wackyfrog/ZD50-controller/README.md

# ZD50-controller
Controller for audio power amplifier. Features: power control with soft start, SPI multi channel volume control, infrared remote control, multicolor backlight.

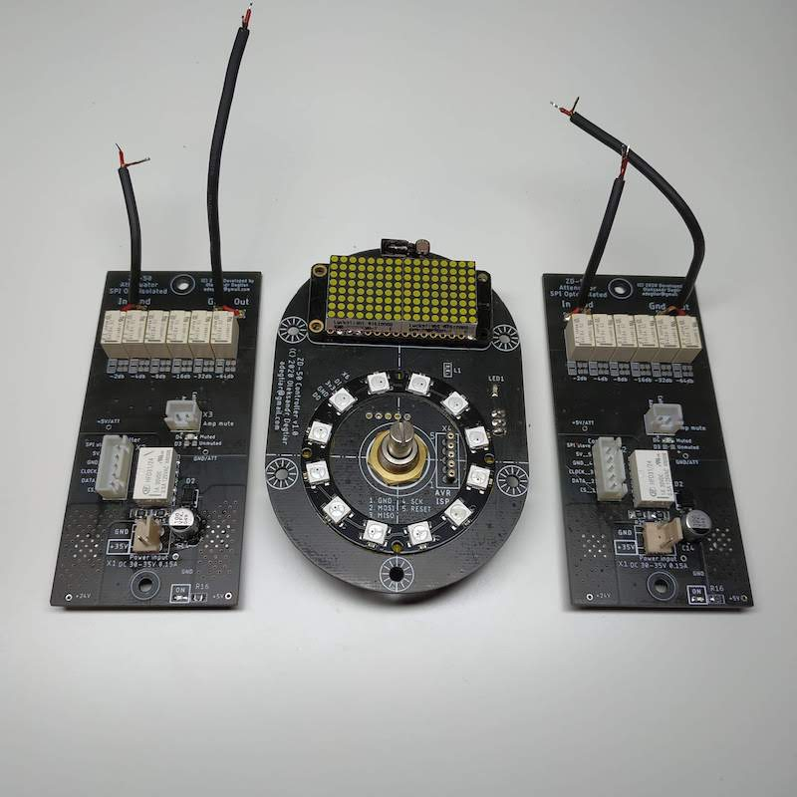
[picture p1: images/IMG_20210211_191846.jpg]
Assembled modules

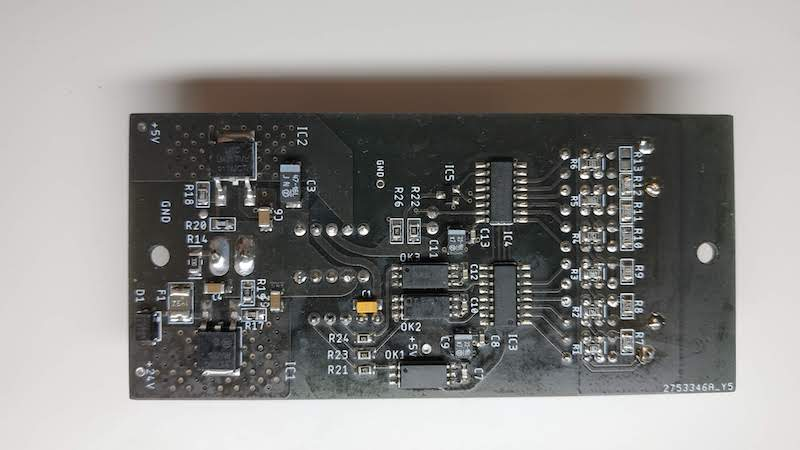
[picture p2: images/IMG_20210211_192029.jpg]
Assembled attenuator, bottom

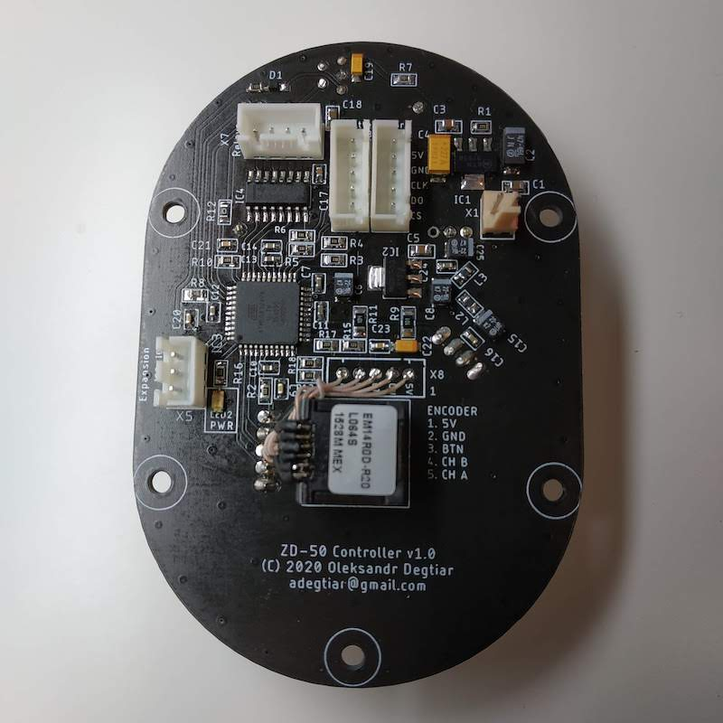
[picture p3: images/IMG_20210211_192253.jpg]
Assembled controller, bottom

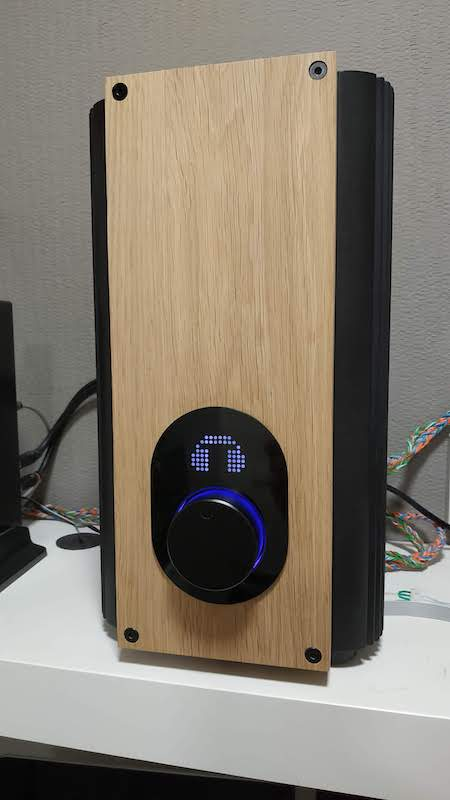
[picture p4: images/IMG_20210302_191737.jpg]
In use
