wackyfrog/ZD50-controller/schematics/Attenuator-schematics.pdf

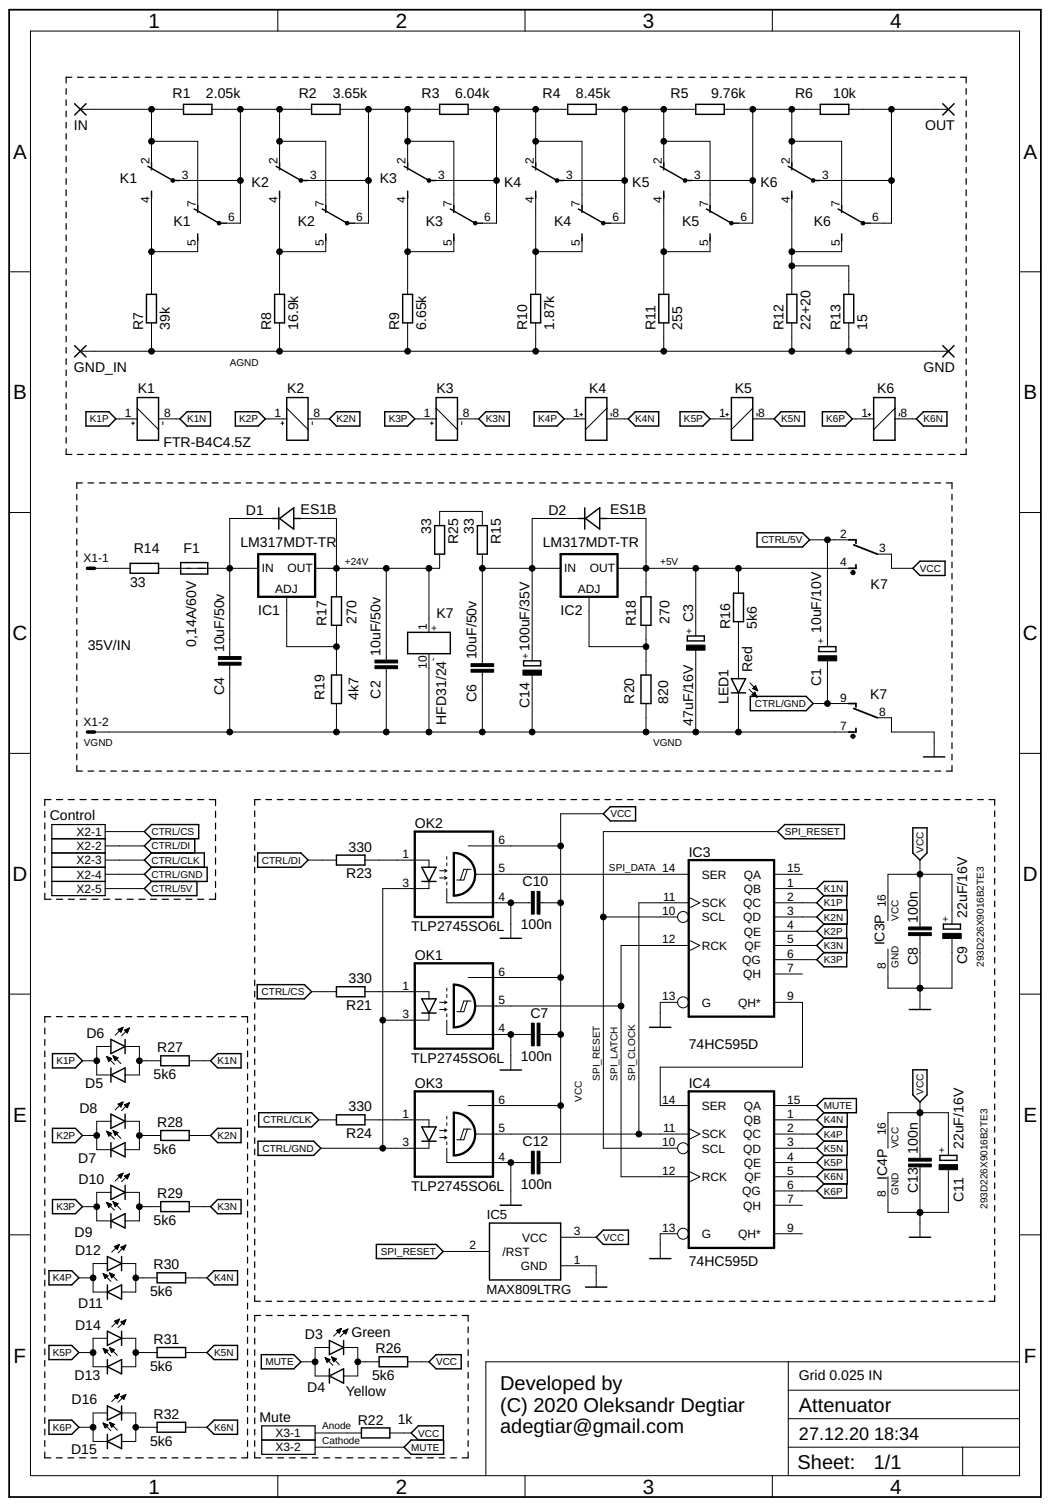
[picture p5: page 1]

X2-4 | CTRL/GND

Grid 0.025 IN Developed by
