wackyfrog/ZD50-controller/schematics/ZD-50 Controller v1.pdf

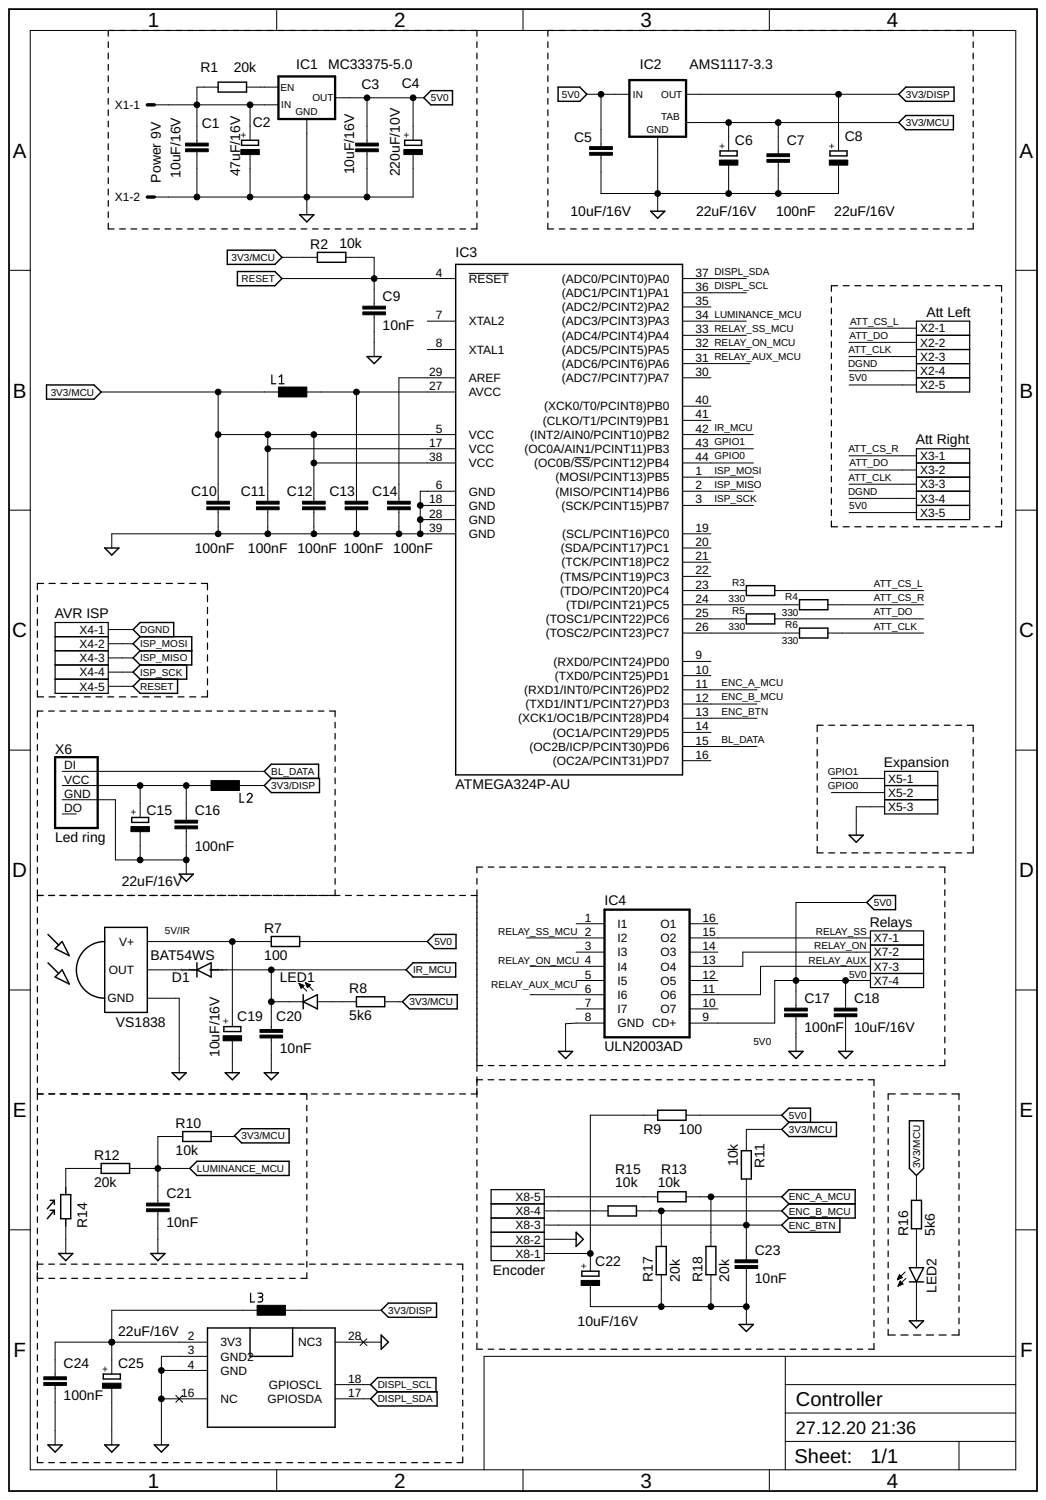
[picture p6: page 1]

5 | Att Right
17 | 43 GPIO1
