wackyfrog/ZD50-controller/schematics/Attenuator.sch

## EAGLE design schematics/Attenuator.sch (2023-03-28)

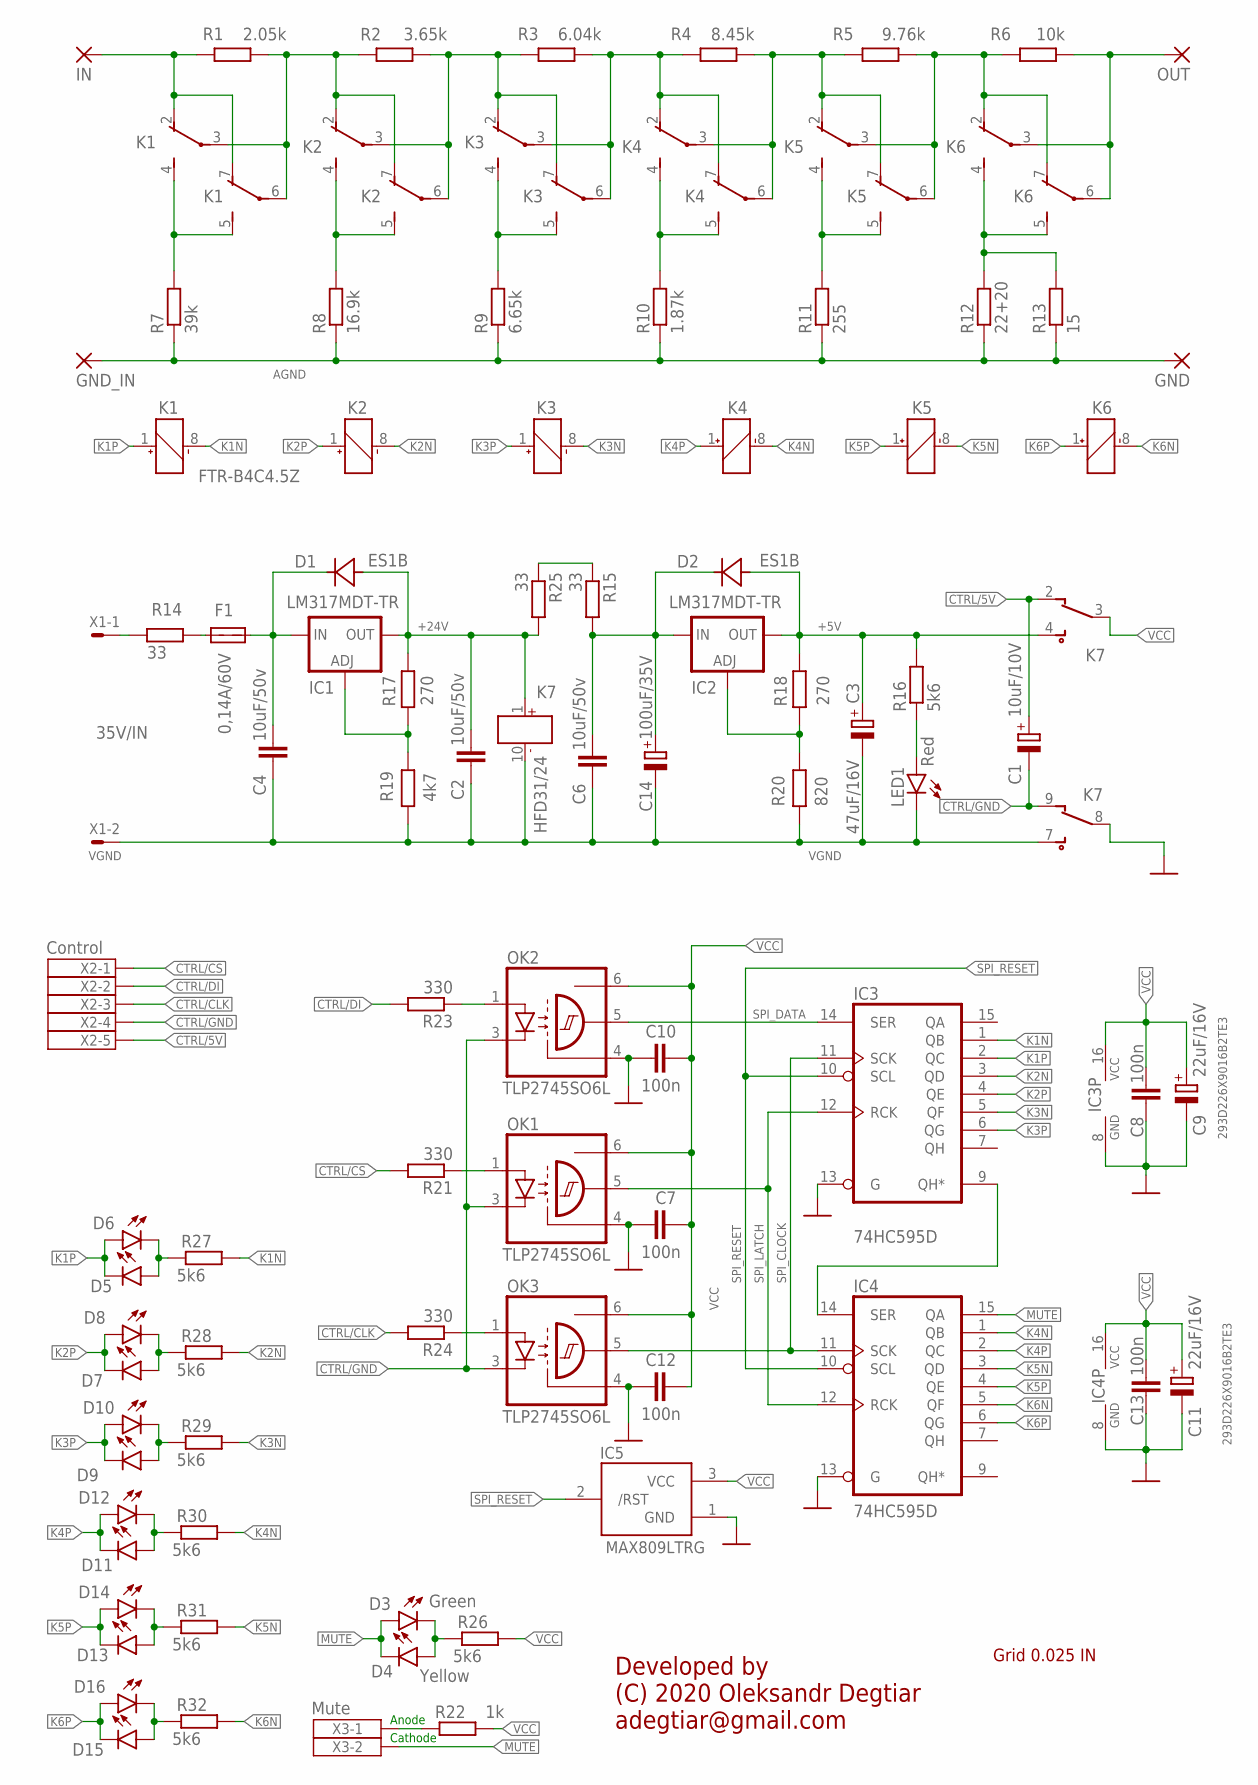
[picture p7: schematic Attenuator.sch]

Parts:
C1: 10uF/10V; SMC_A; PARTNAME TAJA106K010RNJ
C2, C4, C6: 10uF/50v; C1206; PARTNAME CL31B106KBHNNNE
C3: 47uF/16V; SMC_C; PARTNAME 293D476X9016C2TE3
C7, C8, C10, C12, C13: 100n; C0603
C9, C11: 22uF/16V; SMC_B; PARTNAME 293D226X9016B2TE3
C14: 100uF/35V; UD-6,3X5,8_NICHICON; PARTNAME EEEFK1V101XP
D1, D2: ES1B; SMA
D3: Green; CHIPLED_0805
D4: Yellow; CHIPLED_0805
D5, D6, D7, D8, D9, D10, D11, D12, D13, D14, D15, D16: LEDCHIPLED_0805; CHIPLED_0805
F1: 0,14A/60V; MF-MSMF010-2
GND: OUT_GND; 2,54/1,1
GND_IN: IN_GND; 2,54/1,1
IC1: LM317MDT-TR; DPACK
IC2: LM317MDT-TR; DPACK; PARTNAME LM317MDTG
IC3, IC4: 74HC595D; SO16
IC5: MAX809LTRG; SOT23; PARTNAME MAX809LTRG
IN: IN; 2,54/1,1
K1, K2, K3, K4, K5, K6: FTR-B4C4.5Z; FTR-B4C
K7: HFD31/24; HFD31
LED1: Red; CHIPLED_0805
OK1, OK2, OK3: TLP2745SO6L; SO6L
OUT: OUT; 2,54/1,1
R1: 2.05k; R0805
R2: 3.65k; R0805
R3: 6.04k; R0805
R4: 8.45k; R0805
R5: 9.76k; R0805
R6: 10k; R0805
R7: 39k; R0805
R8: 16.9k; R0805
R9: 6.65k; R0805
R10: 1.87k; R0805
R11: 255; R0805
R12: 22+20; R0805
R13: 15; R0805
R14, R15, R25: 33; R1206
R16, R26, R27, R28, R29, R30, R31, R32: 5k6; R0805
R17, R18: 270; R0805
R19: 4k7; R0805
R20: 820; R0805
R21, R23, R24: 330; R0805
R22: 1k; R0805
X1: 35V/IN; KK-156-2
X2: Control; JST-XH-05-PACKAGE-ROUND-PAD
X3: Mute; JST-XH-02-PACKAGE-ROUND-PAD

Connections:
+5V: C3.+, D2.A, IC2.4 (OUT), K7.4 (NO), R16.2, R18.1
+24V: C2.1, D1.A, IC1.4 (OUT), K7.1 (+), R17.1, R25.2
+24V/IN: C6.1, C14.+, D2.C, IC2.3 (IN), R15.2
+35V/FUSE: F1.1, R14.2
+35V/IN: R14.1, X1.1
ADJ_VR1: IC1.1 (ADJ), R17.2, R19.2
ADJ_VR2: IC2.1 (ADJ), R18.2, R20.2
AGND: GND.1, GND_IN.1, R7.1, R8.1, R9.1, R10.1, R11.1, R12.1, R13.1
CTRL/5V: C1.+, K7.2 (NC), X2.5
CTRL/CLK: R24.2, X2.3
CTRL/CS: R21.2, X2.1
CTRL/DI: R23.2, X2.2
CTRL/GND: C1.-, K7.9 (NC), OK1.3 (C), OK2.3 (C), OK3.3 (C), X2.4
GND: C7.2, C8.2, C9.-, C10.2, C11.-, C12.2, C13.1, IC3.8 (GND), IC3.13 (G), IC4.8 (GND), IC4.13 (G), IC5.1 (GND), K7.8 (COM), OK1.4 (GND), OK2.4 (GND), OK3.4 (GND)
K1N: IC3.1 (QB), K1.8 (-), R27.2
K1P: D5.C, D6.A, IC3.2 (QC), K1.1 (+)
K2N: IC3.3 (QD), K2.8 (-), R28.2
K2P: D7.C, D8.A, IC3.4 (QE), K2.1 (+)
K3N: IC3.5 (QF), K3.8 (-), R29.2
K3P: D9.C, D10.A, IC3.6 (QG), K3.1 (+)
K4N: IC4.1 (QB), K4.8 (-), R30.2
K4P: D11.C, D12.A, IC4.2 (QC), K4.1 (+)
K5N: IC4.3 (QD), K5.8 (-), R31.2
K5P: D13.C, D14.A, IC4.4 (QE), K5.1 (+)
K6N: IC4.5 (QF), K6.8 (-), R32.2
K6P: D15.C, D16.A, IC4.6 (QG), K6.1 (+)
LED_PWR_ON: LED1.A, R16.1
MUTE: D3.A, D4.C, IC4.15 (QA), X3.2
unnamed: K5.4 (S), K5.5 (S), R11.2
unnamed: K3.4 (S), K3.5 (S), R9.2
unnamed: K2.4 (S), K2.5 (S), R8.2
unnamed: K1.4 (S), K1.5 (S), R7.2
unnamed: D5.A, D6.C, R27.1
unnamed: K4.4 (S), K4.5 (S), R10.2
unnamed: K4.3, K4.6, K5.2 (O), K5.7 (O), R4.1, R5.2
unnamed: K1.3, K1.6, K2.2 (O), K2.7 (O), R1.1, R2.1
unnamed: IN.1, K1.2 (O), K1.7 (O), R1.2
unnamed: K2.3, K2.6, K3.2 (O), K3.7 (O), R2.2, R3.2
unnamed: K3.3, K3.6, K4.2 (O), K4.7 (O), R3.1, R4.2
unnamed: K6.3, K6.6, OUT.1, R6.1
unnamed: R15.1, R25.1
unnamed: D3.C, D4.A, R26.1
unnamed: D7.A, D8.C, R28.1
unnamed: R22.1, X3.1
unnamed: D9.A, D10.C, R29.1
unnamed: C4.1, D1.C, F1.2, IC1.3 (IN)
unnamed: K5.3, K5.6, K6.2 (O), K6.7 (O), R5.1, R6.2
unnamed: D11.A, D12.C, R30.1
unnamed: D13.A, D14.C, R31.1
unnamed: D15.A, D16.C, R32.1
unnamed: K6.4 (S), K6.5 (S), R12.2, R13.2
unnamed: OK1.1 (A), R21.1
unnamed: OK2.1 (A), R23.1
unnamed: OK3.1 (A), R24.1
RG_CHAIN: IC3.9 (QH*), IC4.14 (SER)
SPI_CLOCK: IC3.11 (SCK), IC4.11 (SCK), OK3.5 (OUT)
SPI_DATA: IC3.14 (SER), OK2.5 (OUT)
SPI_LATCH: IC3.12 (RCK), IC4.12 (RCK), OK1.5 (OUT)
SPI_RESET: IC3.10 (SCL), IC4.10 (SCL), IC5.2 (/RST)
VCC: C7.1, C8.1, C9.+, C10.1, C11.+, C12.1, C13.2, IC3.16 (VCC), IC4.16 (VCC), IC5.3 (VCC), K7.3 (COM), OK1.6 (VCC), OK2.6 (VCC), OK3.6 (VCC), R22.2, R26.2
VGND: C2.2, C3.-, C4.2, C6.2, C14.-, K7.7 (NO), K7.10 (-), LED1.C, R19.1, R20.1, X1.2

Notes on the sheet:
Cathode
Anode
Grid 0.025 IN
Developed by (C) 2020 Oleksandr Degtiar adegtiar@gmail.com
