wackyfrog/ZD50-controller/schematics/Controller v1.1.sch

## EAGLE design schematics/Controller v1.1.sch (2023-03-28)

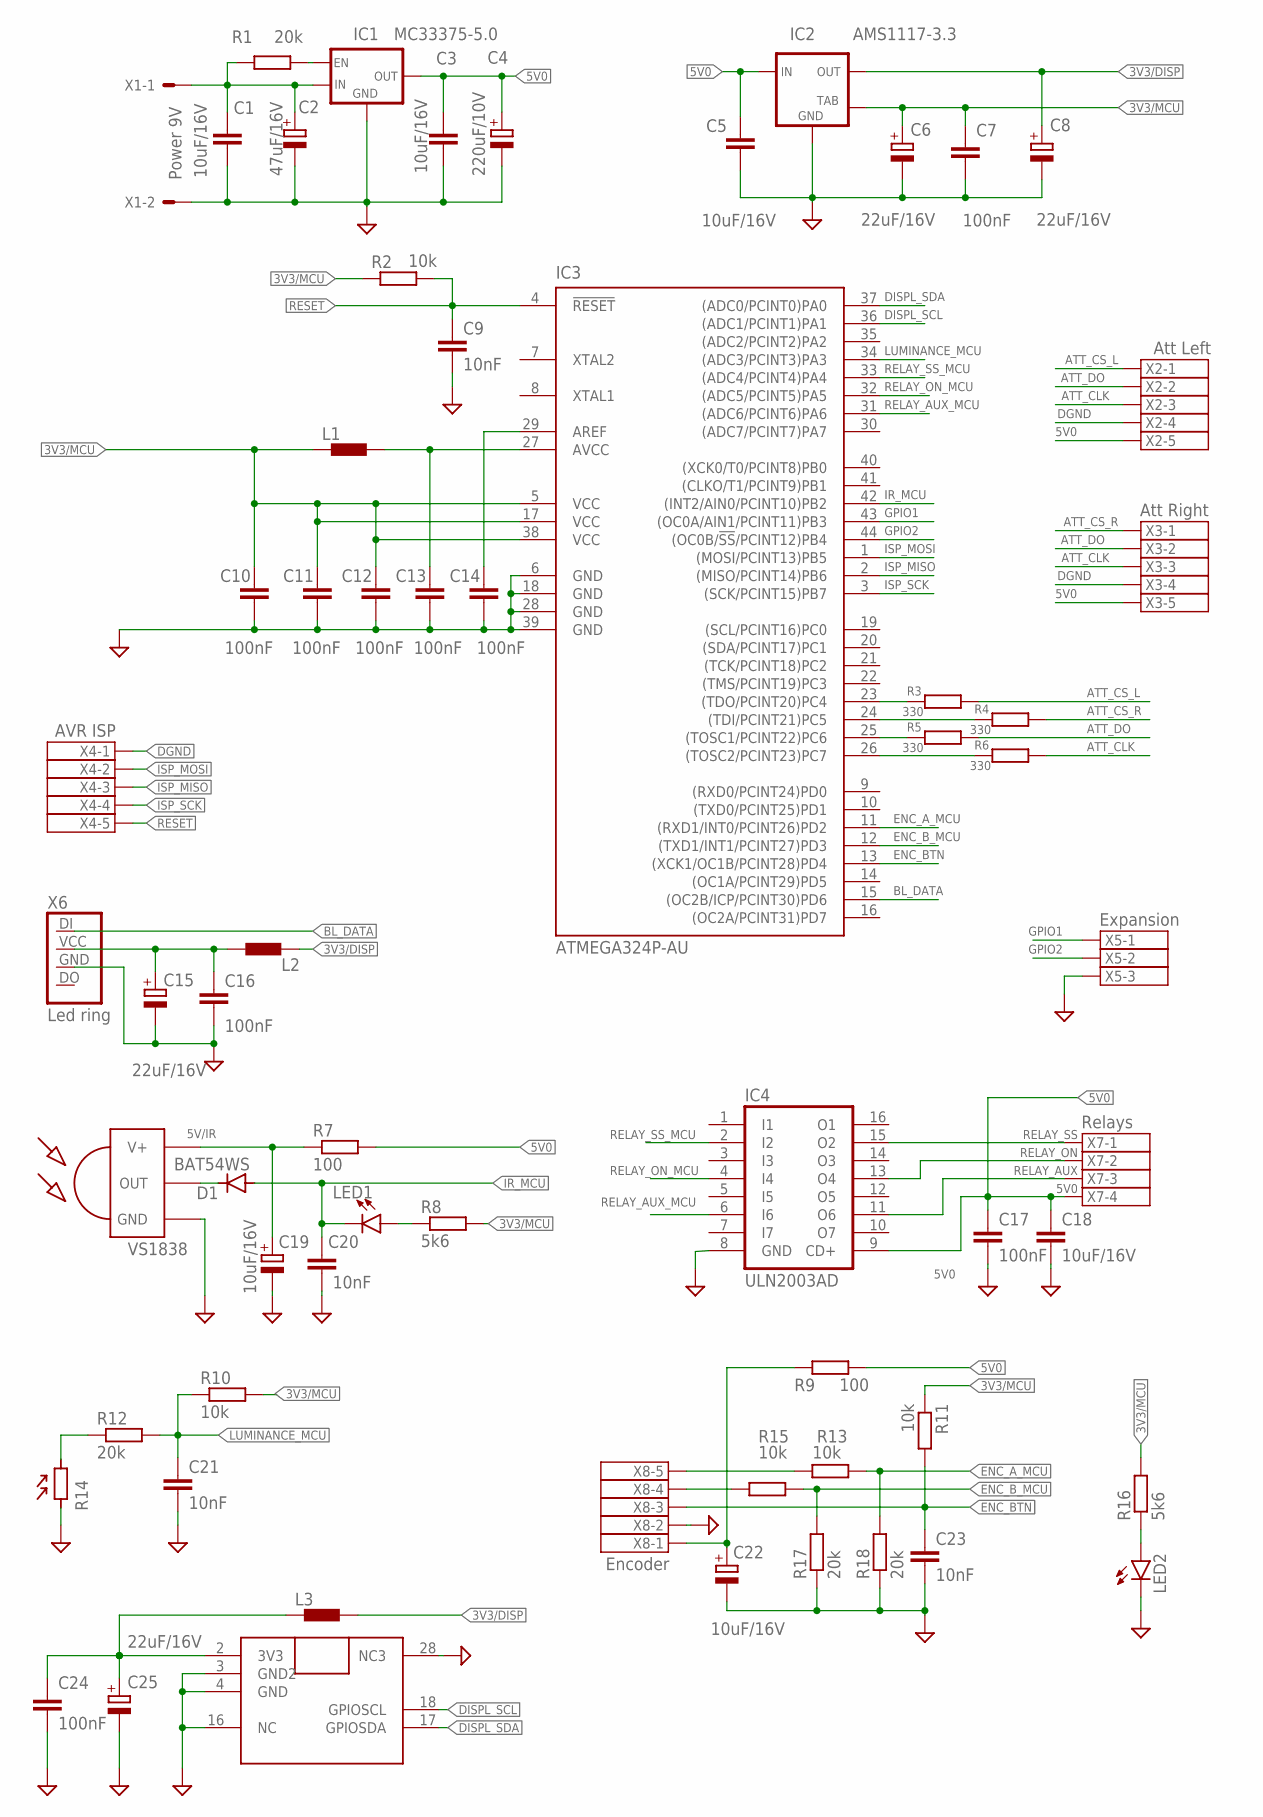
[picture p8: schematic Controller v1.1.sch]

Parts:
C1, C3, C5, C18: 10uF/16V; C0805; PARTNAME CL21B106KOQNNNE
C2: 47uF/16V; SMC_C; PARTNAME 293D476X9016C2TE3
C4: 220uF/10V; SMC_C
C6, C8, C15, C25: 22uF/16V; SMC_B; PARTNAME 293D226X9016B2TE3
C7, C10, C11, C12, C13, C14, C16, C17, C24: 100nF; C0603
C9, C20, C21: 10nF; C0603
C19, C22: 10uF/16V; SMC_A; PARTNAME TAJA106K010RNJ
C23: 10nF; C0603; PARTNAME CL21B106KOQNNNE
D1: BAT54WS; SOD323-W; PARTNAME BAT54WS
DM1: FEATHERWING_ZD50DISPLAY_ZD50; FEATHERWING_ZD50
IC1: MC33375-5.0; SOT223
IC2: AMS1117-3.3; SOT223
IC3: ATMEGA324P-AU; TQFP44
IC4: ULN2003AD; SO16
IR1: VS1838; TSOP18XX
L1, L2: BLM21PG221SN1D; 0805; PARTNAME BLM21PG221SN1D
L3: 10uH; 0805; PARTNAME BLM21PG221SN1D
LED1, LED2: LEDSML0805; SML0805
R1: 20k; R0603
R2, R10, R13, R15: 10k; R0805
R3, R4, R5, R6: 330; R0805
R7: 100; R0805
R8, R16: 5k6; R0805
R9: 100; R1206
R11: 10k; R1206
R12, R17, R18: 20k; R0805
R14: GL5537; GL55
X1: Power 9V; 22-23-2021
X2: Att Left; JST-XH-05-PACKAGE-LONG-PAD
X3: Att Right; JST-XH-05-PACKAGE-LONG-PAD
X4: AVR ISP; JST-XH-05-PACKAGE-LONG-PAD
X5: Expansion; JST-XH-03-PACKAGE-LONG-PAD
X6: Led ring; LED_RING_CONN
X7: Relays; JST-XH-04-PACKAGE-LONG-PAD
X8: Encoder; JST-XH-05-PACKAGE-ROUND-PAD

Connections:
3V3/AVCC: C13.1, IC3.27 (AVCC), L1.2
3V3/DISP: C8.+, IC2.2 (OUT), L2.2, L3.2
3V3/MCU: C6.+, C7.1, C10.1, C11.1, C12.1, IC2.4 (TAB), IC3.5 (VCC), IC3.17 (VCC), IC3.38 (VCC), L1.1, R2.1, R8.2, R10.2, R11.1, R16.2
5V0: C3.1, C4.+, C5.1, C17.1, C18.1, IC1.3 (OUT), IC2.3 (IN), IC4.9 (CD+), R7.2, R9.2, X2.5, X3.5, X7.4
5V/EN: IC1.2 (EN), R1.2
5V/ENC: C22.+, R9.1, X8.1
5V/IR: C19.+, IR1.VCC (V+), R7.1
+9V/IN: C1.1, C2.+, IC1.1 (IN), R1.1, X1.1
AREF: C14.1, IC3.29 (AREF)
ATT_CLK: R6.2, X2.3, X3.3
ATT_CS_L: R3.2, X2.1
ATT_CS_R: R4.2, X3.1
ATT_DO: R5.2, X2.2, X3.2
BL_3V3: C15.+, C16.1, L2.1, X6.VCC
BL_DATA: IC3.15 ((OC2B/ICP/PCINT30)PD6), X6.DI
DGND: C1.2, C2.-, C3.2, C4.-, C5.2, C6.-, C7.2, C8.-, C9.2, C10.2, C11.2, C12.2, C13.2, C14.2, C15.-, C16.2, C17.2, C18.2, C19.-, C20.2, C21.2, C22.-, C23.2, C24.2, C25.-, DM1.3 (GND2), DM1.4 (GND), DM1.16 (NC), DM1.28 (NC3), IC1.4 (GND), IC2.1 (GND), IC3.6 (GND), IC3.18 (GND), IC3.28 (GND), IC3.39 (GND), IC4.8 (GND), IR1.GND, LED2.C, R14.P$1, R17.1, R18.1, X1.2, X2.4, X3.4, X4.1, X5.3, X6.GND, X8.2
DISPL_3V3: C24.1, C25.+, DM1.2 (3V3), L3.1
DISPL_SCL: DM1.18 (GPIOSCL), IC3.36 ((ADC1/PCINT1)PA1)
DISPL_SDA: DM1.17 (GPIOSDA), IC3.37 ((ADC0/PCINT0)PA0)
ENC_A: R13.1, X8.5
ENC_A_MCU: IC3.11 ((RXD1/INT0/PCINT26)PD2), R13.2, R18.2
ENC_B: R15.1, X8.4
ENC_BTN: C23.1, IC3.13 ((XCK1/OC1B/PCINT28)PD4), R11.2, X8.3
ENC_B_MCU: IC3.12 ((TXD1/INT1/PCINT27)PD3), R15.2, R17.2
GPIO1: IC3.43 ((OC0A/AIN1/PCINT11)PB3), X5.1
GPIO2: IC3.44 ((OC0B/!SS!/PCINT12)PB4), X5.2
IR_MCU: C20.1, D1.A, IC3.42 ((INT2/AIN0/PCINT10)PB2), LED1.C
IR_OUT: D1.C, IR1.OUT
ISP_MISO: IC3.2 ((MISO/PCINT14)PB6), X4.3
ISP_MOSI: IC3.1 ((MOSI/PCINT13)PB5), X4.2
ISP_SCK: IC3.3 ((SCK/PCINT15)PB7), X4.4
LIGHT_SENSOR: R12.1, R14.P$2
LUMINANCE_MCU: C21.1, IC3.34 ((ADC3/PCINT3)PA3), R10.1, R12.2
unnamed: LED2.A, R16.1
unnamed: LED1.A, R8.1
unnamed: IC3.23 ((TDO/PCINT20)PC4), R3.1
unnamed: IC3.24 ((TDI/PCINT21)PC5), R4.1
unnamed: IC3.25 ((TOSC1/PCINT22)PC6), R5.1
unnamed: IC3.26 ((TOSC2/PCINT23)PC7), R6.1
RELAY_AUX: IC4.11 (O6), X7.3
RELAY_AUX_MCU: IC3.31 ((ADC6/PCINT6)PA6), IC4.6 (I6)
RELAY_ON: IC4.13 (O4), X7.2
RELAY_ON_MCU: IC3.32 ((ADC5/PCINT5)PA5), IC4.4 (I4)
RELAY_SS: IC4.15 (O2), X7.1
RELAY_SS_MCU: IC3.33 ((ADC4/PCINT4)PA4), IC4.2 (I2)
RESET: C9.1, IC3.4 (!RESET), R2.2, X4.5
