wackyfrog/ZD50-controller/src/ZD50.cpp

//
// Created by Oleksandr Degtiar on 21.10.2020.
//

#include "ZD50.h"
#include "Controller/States.h"
#include "SerialOut.h"

namespace ZD50 {
#if ZD50_DEBUG_SERIAL
    TinySerialOut SerialOut;
#endif

    Controller *controller;

    int volume = -1;

    void init() {
#if ZD50_DEBUG_SERIAL
        SerialOut.begin(0);
        SerialOut.println();
        SerialOut.println();
        SerialOut.println();
        SerialOut.println(F("[ZD50:init]"));
#endif
        POWER_INIT();
        POWER_OFF();

        Backlight::init();
        Display::init();
        Display::setMode(Display::WELCOME);
        Settings::init();
        Attenuator::init();
        ZD50::Attenuator::setMode(Attenuator::POWER_SAVE);
        ZD50::Attenuator::setLevel(MAX_ATTENUATION_LEVEL, true);
        _delay_ms(500);
        ZD50::Attenuator::setLevel(MAX_ATTENUATION_LEVEL, false);
        Display::clear();
        Luminance::init();

        setController(StandbyState::getInstance());
        Button::init();
        Rotary::init();
        IR::init();
    }

    Controller *getController() {
        return controller;
    }

    void setController(Controller *newController, int param) {
        if (newController == controller) {
            return;
        }
        if (controller != nullptr) {
            controller->end();
        }
        if (newController != nullptr) {
            newController->begin(controller, param);
        }
        controller = newController;
    }

    int getVolume() {
        return volume;
    }

    void setVolume(int newVolume) {
        if (newVolume > VOLUME_MAX_VALUE) {
            newVolume = VOLUME_MAX_VALUE;
        }
        if (newVolume < VOLUME_MIN_VALUE) {
            newVolume = VOLUME_MIN_VALUE;
        }

        if (VOLUME_TO_MUTE_STATE(newVolume)) {
            Display::setMode(Display::MUTE);

        } else {
            if (VOLUME_TO_MUTE_STATE(volume)) {
                Display::setMode(Display::VOLUME);

            }
            Display::print((uint8_t) newVolume);
        }

        Attenuator::setLevel(VOLUME_TO_ATTENUATION_LEVEL(newVolume), VOLUME_TO_MUTE_STATE(newVolume));
        volume = newVolume;
    }

    bool handleMenuButton() {
        switch (Button::getState()) {
            case Button::SHORT_PRESS:
                Menu::select();
                break;

            case Button::MIDDLE_PRESS:
                if (!Menu::leave()) {
                    Menu::finish();
                    controller->onMenuClose();
                }
                break;

            case Button::LONG_PRESS:
                Menu::finish();
                controller->onMenuClose();
                break;

            default:
                return false;
        }
        return true;
    }

    bool throttleMovementCommand(Controller::Command &command, int param) {
        static int value = 0;
        static unsigned long resetTime = 0;
        unsigned long now = millis();
        value = now > resetTime ? param : value + param;
        resetTime = now + 200;
        if (abs(value) > 2) {
            value = 0;
            return false;
        }
        return true;
    }

    bool handleMenuCommand(Controller::Command command, int param) {
        if (!Menu::isActive()) {
            return false;
        }

        switch (command) {
            case Controller::Command::BUTTON_PRESS:
                return handleMenuButton();

            case Controller::Command::ROTATE:
                if (!Menu::isEntered() && throttleMovementCommand(command, param)) {
                    return true;
                }
                if (param > 0) {
                    Menu::next();
                } else if (param < 0) {
                    Menu::previous();
                }
                return true;

            default:
                return false;
        }

        return true;
    }

    void command(Controller::Command command, Controller::CommandParam param) {
#if ZD50_DEBUG_COMMANDS
        SerialOut.print(F("CMD:"));
        SerialOut.print(command);
        SerialOut.print(F(" param: "));
        SerialOut.print(param);
        SerialOut.println();
#endif
        if (controller == nullptr) {
            return;
        }
        if (!handleMenuCommand(command, param)) {
            controller->command(command, param);
        }
    }

    COROUTINE(controllerTick) {
        COROUTINE_LOOP() {
            COROUTINE_AWAIT(controller != nullptr);
            controller->tick();
            COROUTINE_DELAY(CONTROLLER_TICK_MS);
        }
    }

    COROUTINE(liminance) {
        COROUTINE_LOOP() {
            COROUTINE_AWAIT(controller != nullptr);
            COROUTINE_DELAY(1000);
            Display::adjustBrightness();
        }
    }

}
