wackyfrog/ZD50-controller/include/Settings.h

//
// Created by Oleksandr Degtiar on 23.02.2021.
//

#ifndef ZD50_CONTROLLER_SETTINGS_H
#define ZD50_CONTROLLER_SETTINGS_H

namespace Settings {
    enum {



    };

    void init();


}

#endif //ZD50_CONTROLLER_SETTINGS_H
