wackyfrog/ZD50-controller/src/Settings.cpp

//
// Created by Oleksandr Degtiar on 23.02.2021.
//

#include "Settings.h"
#include "ZD50.h"
#include <EEPROM.h>

typedef unsigned long CRC32;

unsigned long eeprom_crc(void) {

    const unsigned long crc_table[16] = {
            0x00000000, 0x1db71064, 0x3b6e20c8, 0x26d930ac,
            0x76dc4190, 0x6b6b51f4, 0x4db26158, 0x5005713c,
            0xedb88320, 0xf00f9344, 0xd6d6a3e8, 0xcb61b38c,
            0x9b64c2b0, 0x86d3d2d4, 0xa00ae278, 0xbdbdf21c
    };

    unsigned long crc = ~0L;

    int length = EEPROM.length() - sizeof(CRC32);
    for (int index = 0; index < length; ++index) {
        crc = crc_table[(crc ^ EEPROM[index]) & 0x0f] ^ (crc >> 4);
        crc = crc_table[(crc ^ (EEPROM[index] >> 4)) & 0x0f] ^ (crc >> 4);
        crc = ~crc;
    }

    return crc;
}

void Settings::init() {
#if ZD50_DEBUG_SERIAL
    ZD50::SerialOut.print("EEPROM length: ");
    ZD50::SerialOut.println(EEPROM.length());

    ZD50::SerialOut.print("CRC32 of EEPROM data: 0x");
    ZD50::SerialOut.println(eeprom_crc(), HEX);
#endif
}
