wackyfrog/ZD50-controller/(commit log)

2021-02-19 Button logic rewritten
2021-02-22 Controller: Removed pendingController - added arg 'param' in setController to pass. Rewritten timers, removed command TIMEOUT.
2021-02-23 Added setup menu Hue/Saturation/Lightness for standby state. Bugfixes.
    [Backlight.cpp, Config.h, Display.cpp, Display.h]
2021-02-24 BACKLIGHT_MAX_LIGHTNESS set to 60 due power supply limitations.
2021-02-24 Menu & backlight scene performer refactoring, bugfixes.
    [ZD50.cpp, ZD50.h]
2021-02-25 Fixing configuration for multiple targets; Atmega32u4
    [Backlight.cpp, Config.h, PowerControl.h, SerialOut.cpp, SoftI2C.cpp, ZD50.cpp, ZD50.h, main.cpp]
2021-05-12 Release r1.00 Attenuator: Bi-stable relay pulse enlarged to 5ms; Button: debounce decreased to 30ms; Rotary encoder: decreased update time to 10ms Backlight: added HSV conversion macros; added animat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
    [Attenuator.h, Backlight.h, Button.cpp, Button.h, Display.cpp, Display.h, IR.cpp, IR.h]
2021-07-07 Fixed: the brightness level of the display was not restored when turned on; the initial value of the brightness sensor was lost; refactoring
    [Display.cpp, Display.h, ZD50.cpp]
2021-08-05 Fixed: display was empty after switch mode from SourceOn to ON
    [ZD50.cpp]
2021-08-31 Fully working RC5 IR remote control with repeating, delay before repeating, multifunctional POWER button (short, middle, long press). Supported buttons: POWER, VOL+, VOL-, MUTE. Functions: power on/o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
    [Button.cpp, Button.h, IR.cpp, IR.h]
2023-03-28 Added schematics
    [Attenuator.sch, Controller v1.1.sch]
