wackyfrog/ZD50-controller/(notices)

Notices in the files:
src/SerialOut.cpp:
TinySerialOut is free software: you can redistribute it and/or modify
it under the terms of the GNU General Public License as published by
along with this program. If not, see <http://www.gnu.org/licenses/gpl.html>.
